SebiR/Isolated_DMX_Module/README.md

# Isolated DMX module
A module that can be used to create an isolated DMX or RS485 input and output for your project

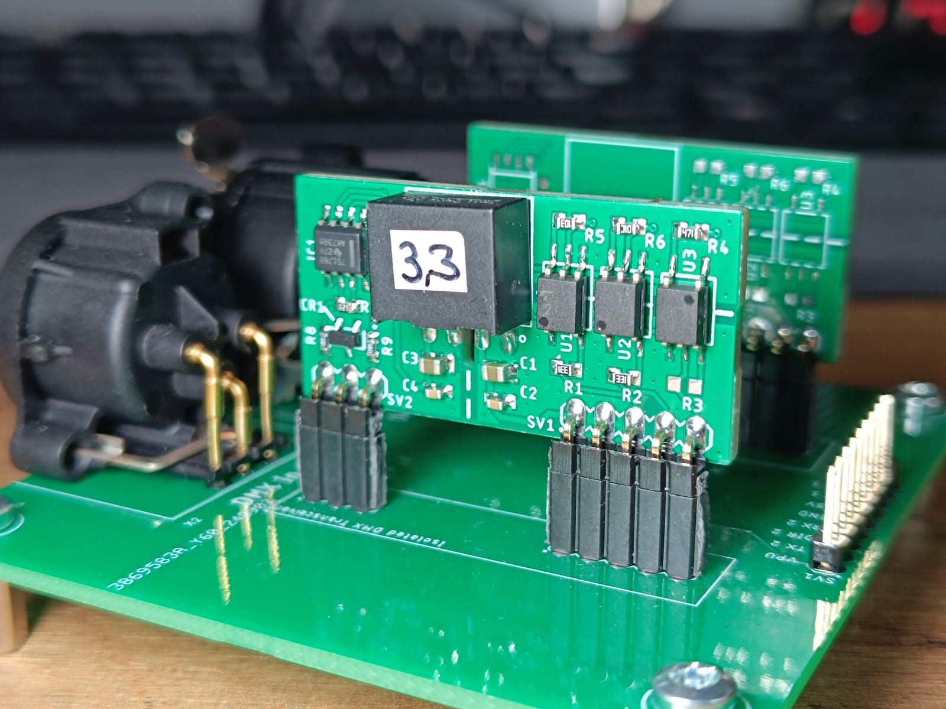
[picture p1: doc/dmx_module.jpg]


## Features
* For 3.3V and 5V systems
* Isolated up to 1kV
* protection on isolated side
* Comes with a small eval board
