SebiR/Isolated_DMX_Module/output/DMX_Eval_Board_SCH.pdf

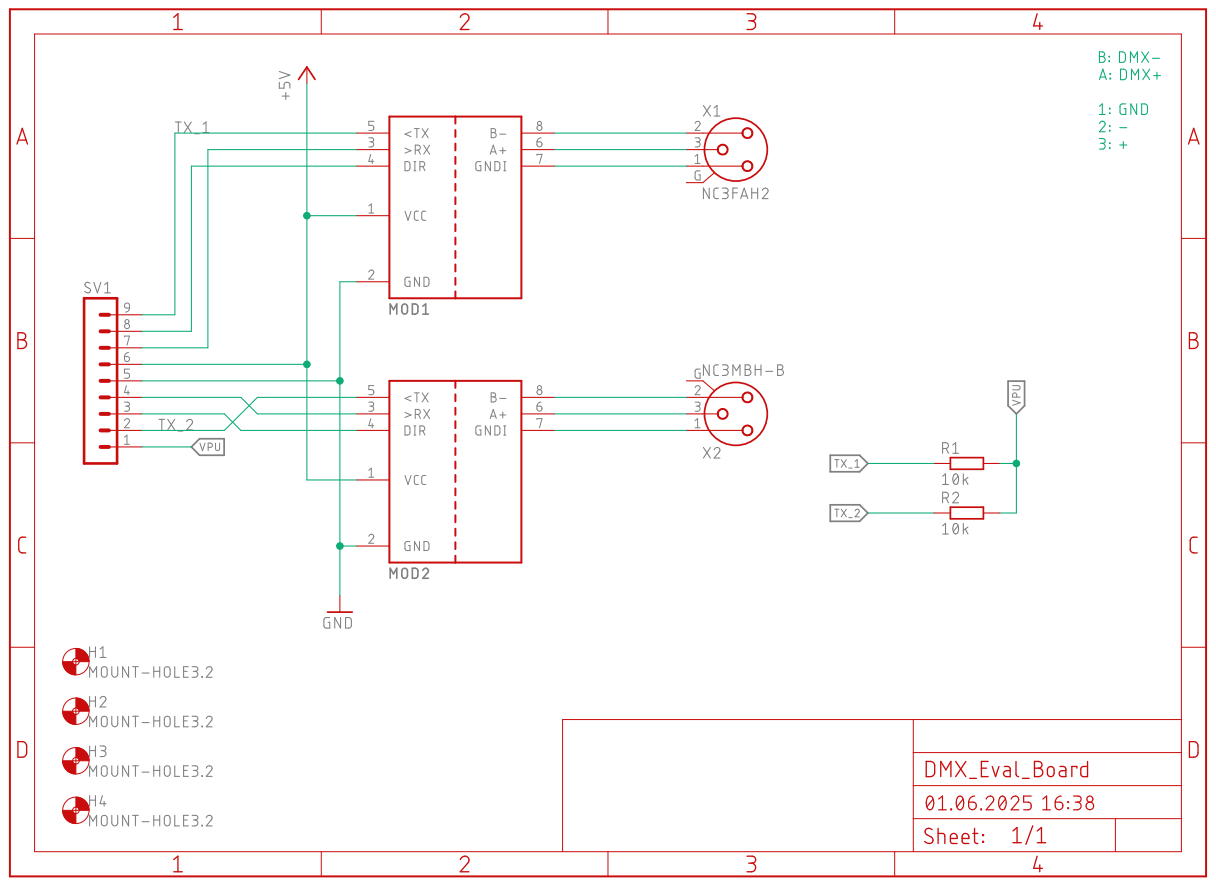
[picture p2: page 1]
