SebiR/Isolated_DMX_Module/output/Isolated_DMX_Module_SCH.pdf

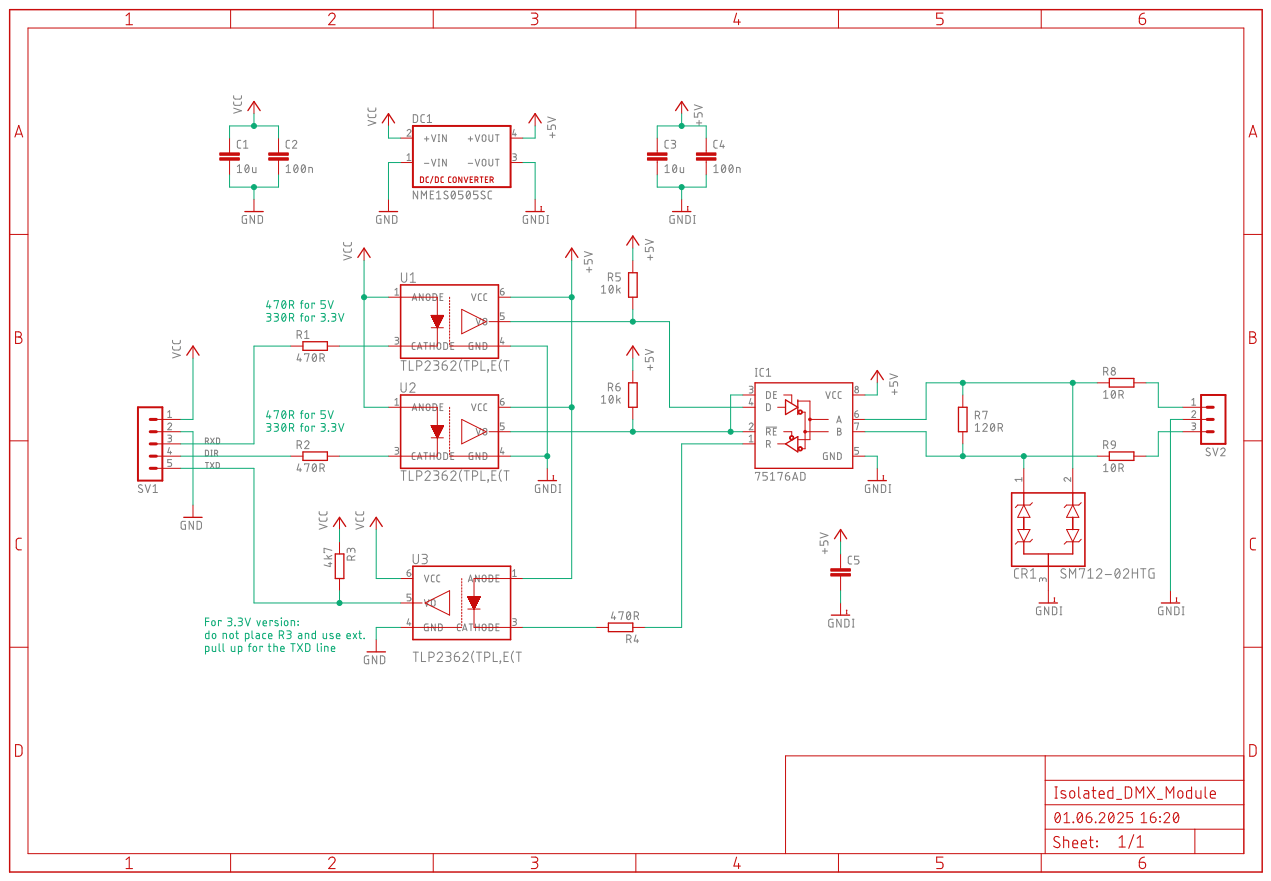
[picture p3: page 1]
