SebiR/Isolated_DMX_Module/DMX_Eval_Board.brd

## EAGLE design DMX_Eval_Board.brd (2025-06-04)

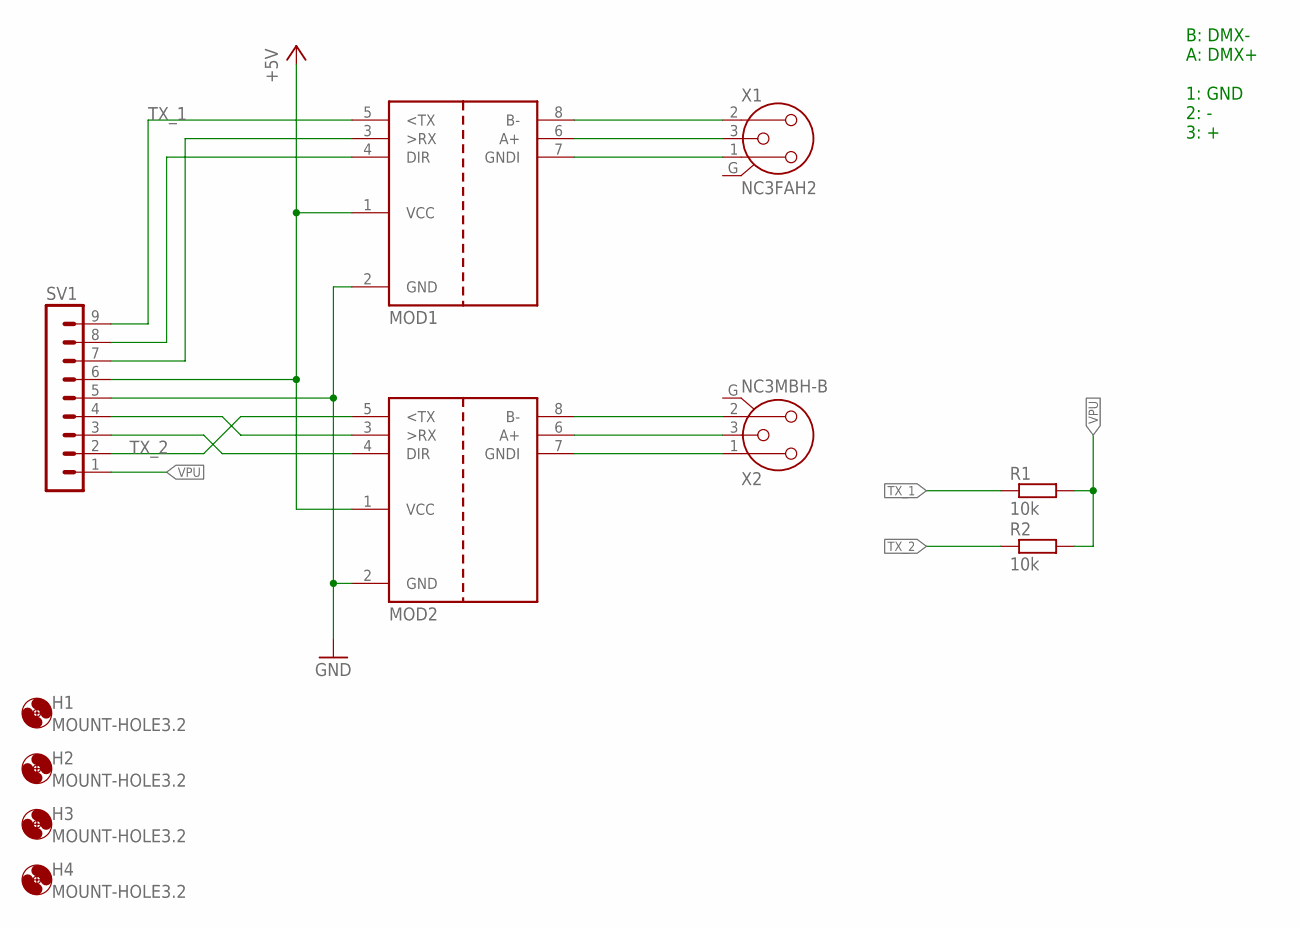
[picture p4: schematic DMX_Eval_Board.sch]

Parts:
H1, H2, H3, H4: MOUNT-HOLE3.2; 3,2
MOD1, MOD2: ISOL_DMX_TRANSCEIVER; MODULE_DMX_ISO
R1, R2: 10k; R0603
SV1: MA09-1
X1: NC3FAH2
X2: NC3MBH-B

Connections:
+5V: MOD1.1 (VCC), MOD2.1 (VCC), SV1.6
GND: MOD1.2 (GND), MOD2.2 (GND), SV1.5
unnamed: MOD1.7 (GNDI), X1.1 (2)
unnamed: MOD2.7 (GNDI), X2.1
unnamed: MOD2.8 (B-), X2.2
unnamed: MOD2.6 (A+), X2.3
unnamed: MOD1.6 (A+), X1.3
unnamed: MOD1.8 (B-), X1.2 (1)
unnamed: MOD2.4 (DIR), SV1.3
unnamed: MOD2.3 (>RX), SV1.4
unnamed: MOD1.4 (DIR), SV1.8
unnamed: MOD1.3 (>RX), SV1.7
TX_1: MOD1.5 (<TX), R1.1, SV1.9
TX_2: MOD2.5 (<TX), R2.1, SV1.2
VPU: R1.2, R2.2, SV1.1

Notes on the sheet:
B: DMX- A: DMX+ 1: GND 2: - 3: +

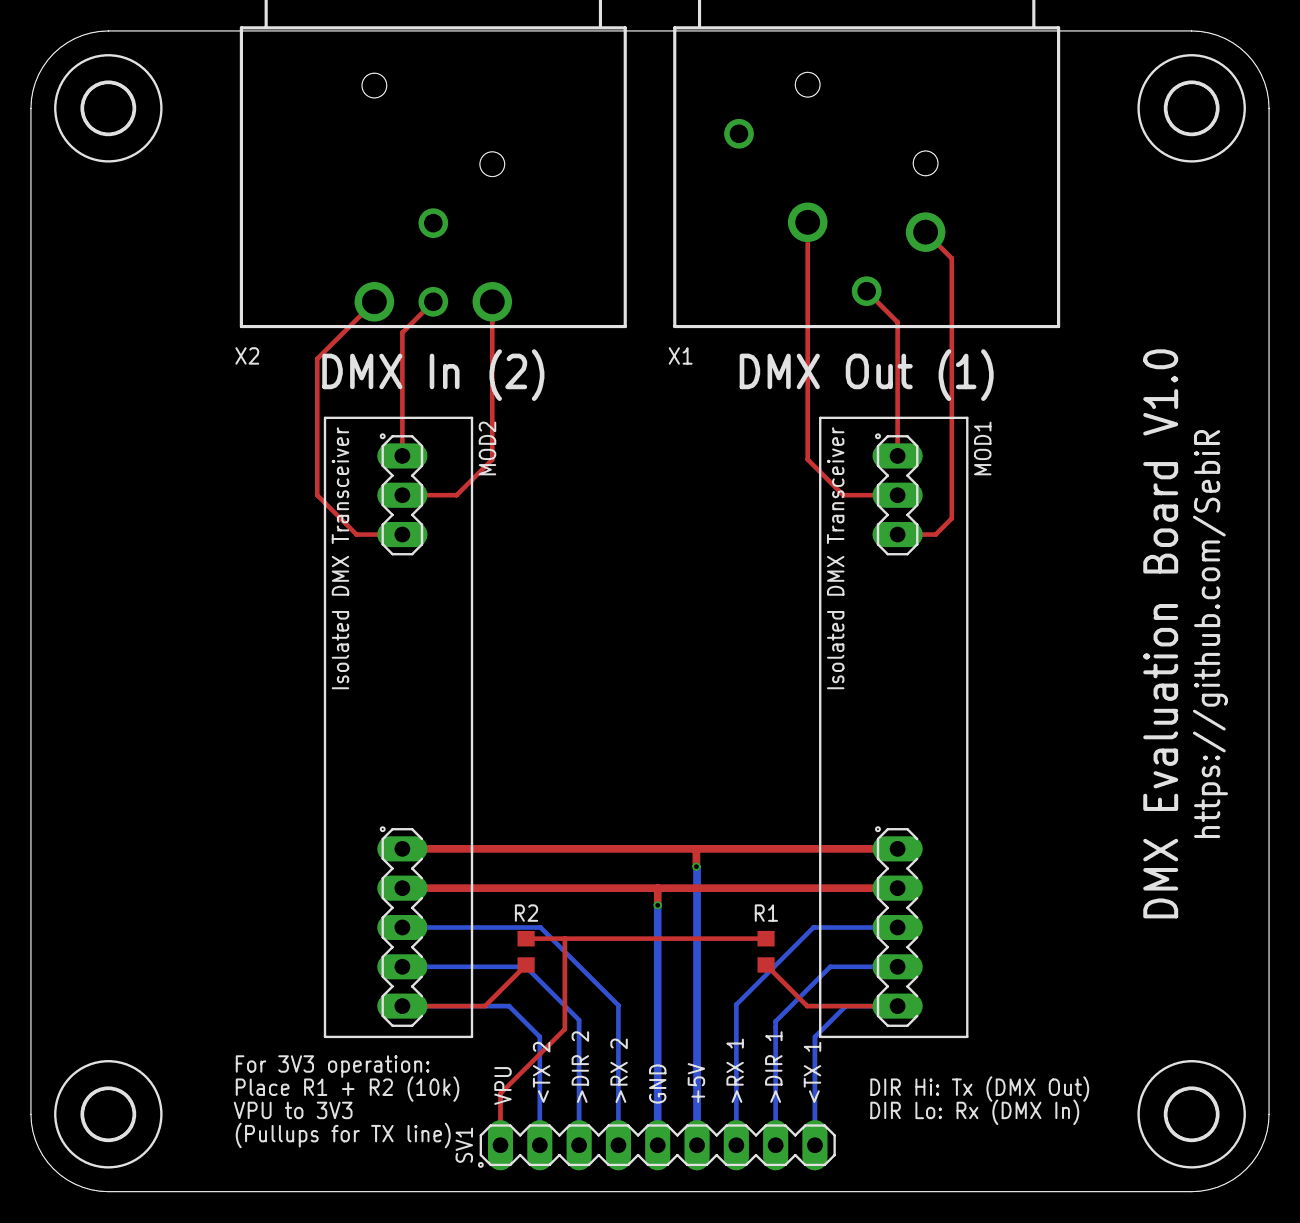
[picture p5: board DMX_Eval_Board.brd from above]

Board: 2 copper layers, 80.0 x 75.0 mm, 11 parts (0 on the bottom side), 15 nets.
