SebiR/Isolated_DMX_Module/Isolated_DMX_Module.brd

## EAGLE design Isolated_DMX_Module.brd (2025-06-04)

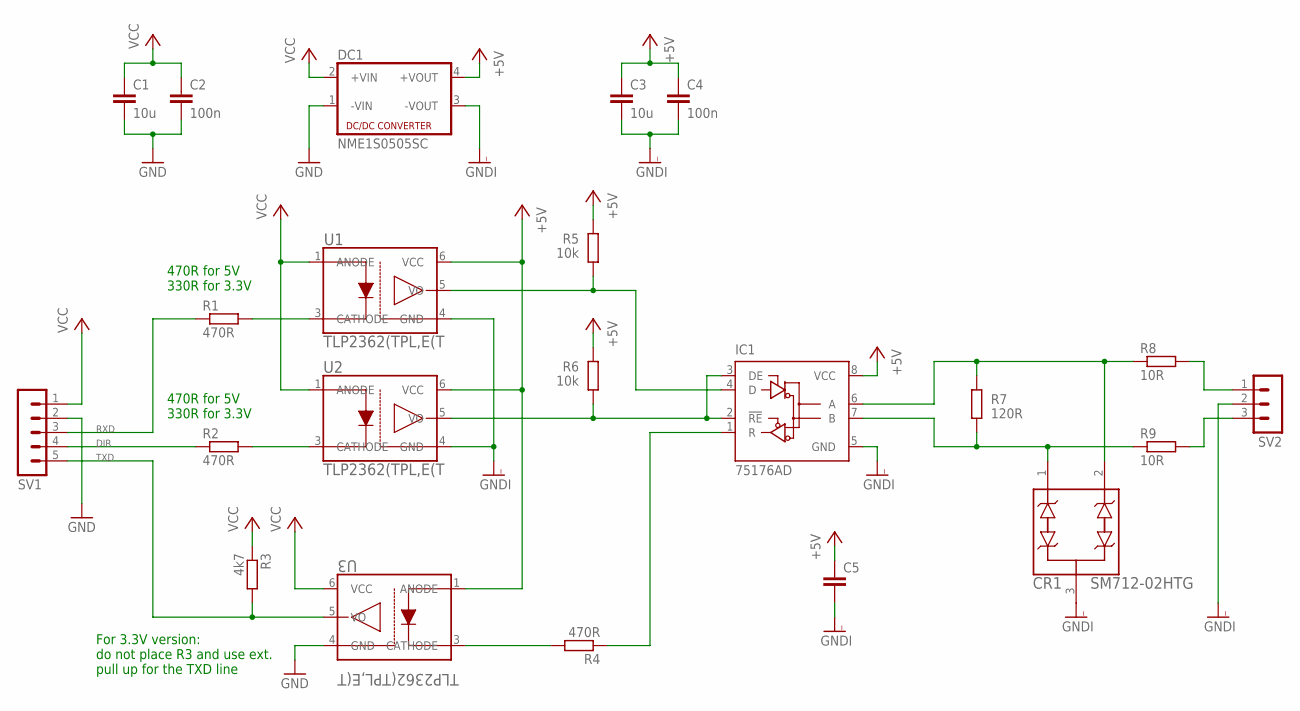
[picture p6: schematic Isolated_DMX_Module.sch]

Parts:
C1, C3: 10u; C0805
C2, C4: 100n; C0603
C5: C-EUC0603; C0603
CR1: SM712-02HTG; SOT23-3_LTF
DC1: NME1S0505SC; NME_FLAT
IC1: 75176AD; D_R-PDSO-G8
R1, R2, R4: 470R; R0603
R3: 4k7; R0603
R5, R6: 10k; R0603
R7: 120R; R0603
R8, R9: 10R; R0603
SV1: MA05-1
SV2: MA03-1
U1, U2, U3: TLP2362(TPL,E(T; 11-4L1S_TOS

Connections:
+5V: C3.1, C4.1, C5.1, DC1.4 (+VOUT), IC1.8 (VCC), R5.1, R6.1, U1.6 (VCC), U2.6 (VCC), U3.1 (ANODE)
DIR: R2.1, SV1.4
GND: C1.2, C2.2, DC1.1 (-VIN), SV1.2, U3.4 (GND)
GNDI: C3.2, C4.2, C5.2, CR1.3, DC1.3 (-VOUT), IC1.5 (GND), SV2.2, U1.4 (GND), U2.4 (GND)
unnamed: IC1.1 (R), R4.1
unnamed: R4.2, U3.3 (CATHODE)
unnamed: IC1.2 (!RE), IC1.3 (DE), R6.2, U2.5 (VO)
unnamed: IC1.4 (D), R5.2, U1.5 (VO)
unnamed: R1.2, U1.3 (CATHODE)
unnamed: R2.2, U2.3 (CATHODE)
unnamed: R8.2, SV2.1
unnamed: R9.2, SV2.3
unnamed: CR1.2, IC1.6 (A), R7.1, R8.1
unnamed: CR1.1, IC1.7 (B), R7.2, R9.1
RXD: R1.1, SV1.3
TXD: R3.2, SV1.5, U3.5 (VO)
VCC: C1.1, C2.1, DC1.2 (+VIN), R3.1, SV1.1, U1.1 (ANODE), U2.1 (ANODE), U3.6 (VCC)

Notes on the sheet:
470R for 5V 330R for 3.3V
For 3.3V version: do not place R3 and use ext. pull up for the TXD line

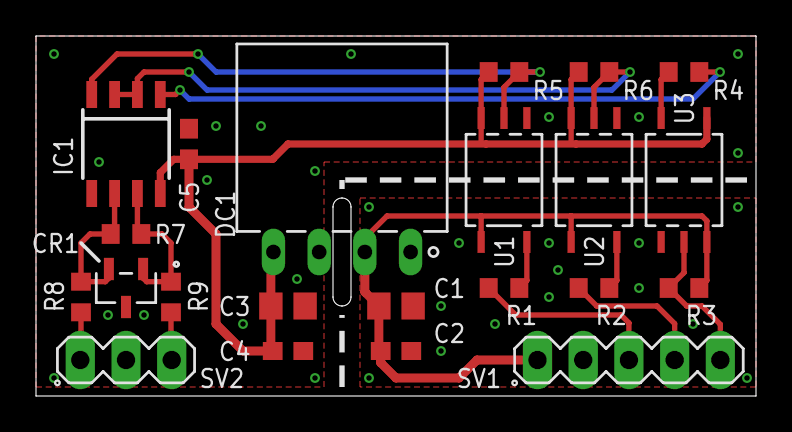
[picture p7: board Isolated_DMX_Module.brd from above]

Board: 2 copper layers, 40.0 x 20.0 mm, 22 parts (0 on the bottom side), 17 nets.
