SebiR/Isolated_DMX_Module/(notices)

Notices in the files:
parts and their libraries:
COPYRIGHT: Copyright (C) 2024 Ultra Librarian. All rights reserved.
